subhra20/TetraGate/Gateway/LoRa_Gateway_TFT_EEPROM.pdf

05/09/2026

LoRa_Gateway_TFT_EEPROM Project Configuration Report

## 1. Description

### 1.1. Project

Project Name | LoRa_Gateway_TFT_EEPROM
Board Name | NUCLEO-F429ZI
Generated with: | STM32CubeMX 6.15.0
Date | 09/05/2026

### 1.2. MCU

MCU Series | STM32F4
MCU Line | STM32F429/439
MCU name | STM32F429ZITx
MCU Package | LQFP144
MCU Pin number | 144

### 1.3. Core(s) information

Core(s) | Arm Cortex-M4

## 2. Pinout Configuration

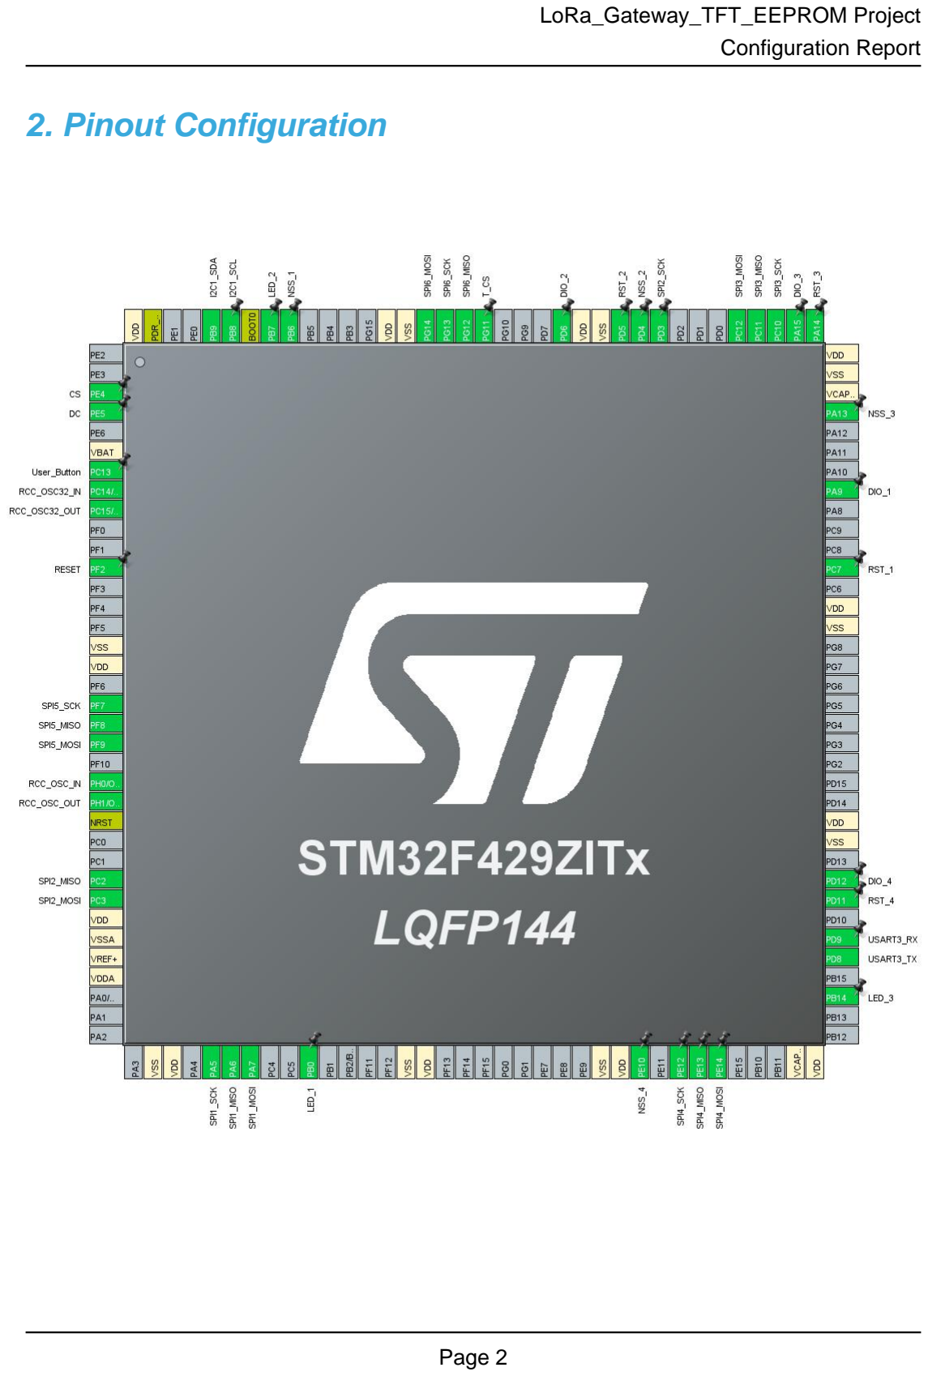
[picture p8: page 3]

## 3. Pins Configuration

Pin Number LQFP144 | Pin Name (function after reset) | Pin Type | Alternate Function(s) | Label
3 | PE4 * | I/O | GPIO_Output | CS
4 | PE5 * | I/O | GPIO_Output | DC
6 | VBAT | Power
7 | PC13 | I/O | GPIO_EXTI13 | User_Button
8 | PC14/OSC32_IN | I/O | RCC_OSC32_IN
9 | PC15/OSC32_OUT | I/O | RCC_OSC32_OUT
12 | PF2 * | I/O | GPIO_Output | RESET
16 | VSS | Power
17 | VDD | Power
19 | PF7 | I/O | SPI5_SCK
20 | PF8 | I/O | SPI5_MISO
21 | PF9 | I/O | SPI5_MOSI
23 | PH0/OSC_IN | I/O | RCC_OSC_IN
24 | PH1/OSC_OUT | I/O | RCC_OSC_OUT
25 | NRST | Reset
28 | PC2 | I/O | SPI2_MISO
29 | PC3 | I/O | SPI2_MOSI
30 | VDD | Power
31 | VSSA | Power
32 | VREF+ | Power
33 | VDDA | Power
38 | VSS | Power
39 | VDD | Power
41 | PA5 | I/O | SPI1_SCK
42 | PA6 | I/O | SPI1_MISO
43 | PA7 | I/O | SPI1_MOSI
46 | PB0 * | I/O | GPIO_Output | LED_1
51 | VSS | Power
52 | VDD | Power
61 | VSS | Power
62 | VDD | Power
63 | PE10 * | I/O | GPIO_Output | NSS_4
65 | PE12 | I/O | SPI4_SCK
66 | PE13 | I/O | SPI4_MISO
67 | PE14 | I/O | SPI4_MOSI
71 | VCAP_1 | Power

Pin Number LQFP144 | Pin Name (function after reset) | Pin Type | Alternate Function(s) | Label
72 | VDD | Power
75 | PB14 * | I/O | GPIO_Output | LED_3
77 | PD8 | I/O | USART3_TX
78 | PD9 | I/O | USART3_RX
80 | PD11 * | I/O | GPIO_Output | RST_4
81 | PD12 | I/O | GPIO_EXTI12 | DIO_4
83 | VSS | Power
84 | VDD | Power
94 | VSS | Power
95 | VDD | Power
97 | PC7 * | I/O | GPIO_Output | RST_1
101 | PA9 | I/O | GPIO_EXTI9 | DIO_1
105 | PA13 * | I/O | GPIO_Output | NSS_3
106 | VCAP_2 | Power
107 | VSS | Power
108 | VDD | Power
109 | PA14 * | I/O | GPIO_Output | RST_3
110 | PA15 | I/O | GPIO_EXTI15 | DIO_3
111 | PC10 | I/O | SPI3_SCK
112 | PC11 | I/O | SPI3_MISO
113 | PC12 | I/O | SPI3_MOSI
117 | PD3 | I/O | SPI2_SCK
118 | PD4 * | I/O | GPIO_Output | NSS_2
119 | PD5 * | I/O | GPIO_Output | RST_2
120 | VSS | Power
121 | VDD | Power
122 | PD6 | I/O | GPIO_EXTI6 | DIO_2
126 | PG11 * | I/O | GPIO_Output | T_CS
127 | PG12 | I/O | SPI6_MISO
128 | PG13 | I/O | SPI6_SCK
129 | PG14 | I/O | SPI6_MOSI
130 | VSS | Power
131 | VDD | Power
136 | PB6 * | I/O | GPIO_Output | NSS_1
137 | PB7 * | I/O | GPIO_Output | LED_2
138 | BOOT0 | Boot
139 | PB8 | I/O | I2C1_SCL
140 | PB9 | I/O | I2C1_SDA
143 | PDR_ON | Reset

Pin Number LQFP144 | Pin Name (function after reset) | Pin Type | Alternate Function(s) | Label
144 | VDD | Power

* The pin is affected with an I/O function

## 4. Clock Tree Configuration

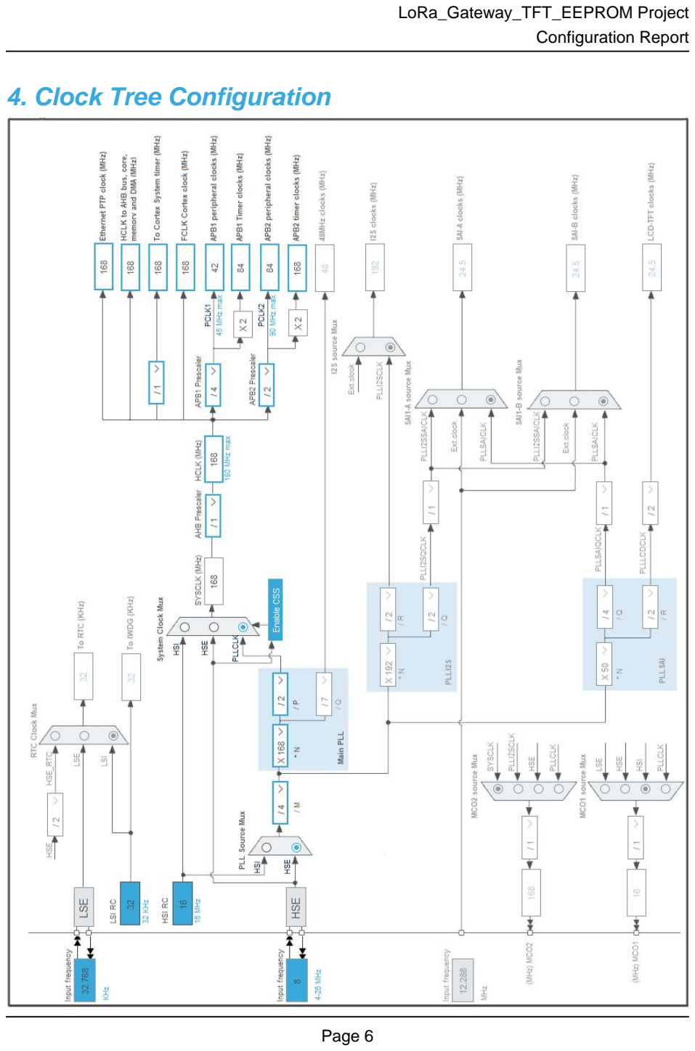
[picture p9: page 7]

## 1. Power Consumption Calculator report

### 1.1. Microcontroller Selection

Series | STM32F4
Line | STM32F429/439
MCU | STM32F429ZITx
Datasheet | DS9405_Rev9

### 1.2. Parameter Selection

Temperature | 25
Vdd | 3.3

### 1.3. Battery Selection

Battery | Li-SOCL2(A3400)
Capacity | 3400.0 mAh
Self Discharge | 0.08 %/month
Nominal Voltage | 3.6 V
Max Cont Current | 100.0 mA
Max Pulse Current | 200.0 mA
Cells in series | 1
Cells in parallel | 1

### 1.4. Sequence

Step | Step1 | Step2
Mode | RUN | STOP_UDM (Under Drive)
Vdd | 3.3 | 3.3
Voltage Source | Battery | Battery
Range | Scale1-High | No Scale
Fetch Type | FLASH | n/a
CPU Frequency | 180 MHz | 0 Hz
Clock Configuration | HSE PLL | Regulator_LP Flash-PwrDwn
Clock Source Frequency | 4 MHz | 0 Hz
Peripherals
Additional Cons. | 0 mA | 0 mA
Average Current | 57 mA | 100 µA
Duration | 0.1 ms | 0.9 ms
DMIPS | 225.0 | 0.0
Ta Max | 97.48 | 104.99
Category | In DS Table | In DS Table

### 1.5. Results

Sequence Time | 1 ms | Average Current | 5.79 mA
Battery Life | 24 days, 10 hours Average DMIPS | | 225.0 DMIPS

### 1.6. Chart

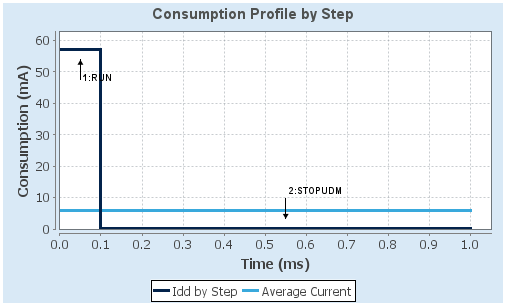
[picture p10: figure]

## 2. Software Project

### 2.1. Project Settings

Name | Value
Project Name | LoRa_Gateway_TFT_EEPROM
Project Folder | D:\STM32 CubeIDE
Toolchain / IDE | STM32CubeIDE
Firmware Package Name and Version | STM32Cube FW_F4 V1.28.3
Application Structure | Advanced
Generate Under Root | Yes
Do not generate the main() | No
Minimum Heap Size | 0x200
Minimum Stack Size | 0x400

### 2.2. Code Generation Settings

Name | Value
STM32Cube MCU packages and embedded software | Copy only the necessary library files
Generate peripheral initialization as a pair of '.c/.h' files | No
Backup previously generated files when re-generating | No
Keep User Code when re-generating | Yes
Delete previously generated files when not re-generated | Yes
Set all free pins as analog (to optimize the power consumption) | No
Enable Full Assert | No

### 2.3. Advanced Settings - Generated Function Calls

Rank | Function Name | Peripheral Instance Name
1 | SystemClock_Config | RCC
2 | MX_GPIO_Init | GPIO
3 | MX_I2C1_Init | I2C1
4 | MX_SPI1_Init | SPI1
5 | MX_SPI2_Init | SPI2
6 | MX_SPI3_Init | SPI3
7 | MX_SPI4_Init | SPI4
8 | MX_SPI5_Init | SPI5
9 | MX_SPI6_Init | SPI6
10 | MX_USART3_UART_Init | USART3

## 3. Peripherals and Middlewares Configuration

### 3.1. I2C1

I2C: I2C
3.1.1. Parameter Settings:

Master Features:

I2C Speed Mode | Fast Mode *
I2C Clock Speed (Hz) | 400000
Fast Mode Duty Cycle | Duty cycle Tlow/Thigh = 2
Timing configuration:
Coefficient of Digital Filter | 0
Analog Filter | Enabled
Slave Features:
Clock No Stretch Mode | Disabled
Primary Address Length selection | 7-bit
Dual Address Acknowledged | Disabled
Primary slave address | 0
General Call address detection | Disabled

### 3.2. RCC

High Speed Clock (HSE): Crystal/Ceramic Resonator Low Speed Clock (LSE) : Crystal/Ceramic Resonator
3.2.1. Parameter Settings:

System Parameters:

VDD voltage (V) | 3.3
Instruction Cache | Enabled
Prefetch Buffer | Enabled
Data Cache | Enabled
Flash Latency(WS) | 5 WS (6 CPU cycle)
RCC Parameters:
HSI Calibration Value | 16
TIM Prescaler Selection | Disabled
HSE Startup Timout Value (ms) | 100
LSE Startup Timout Value (ms) | 5000
Power Parameters:
Power Regulator Voltage Scale | Power Regulator Voltage Scale 1
Power Over Drive | Disabled

### 3.3. SPI1

Mode: Full-Duplex Master
3.3.1. Parameter Settings:

Basic Parameters:

Frame Format | Motorola
Data Size | 8 Bits
First Bit | MSB First
Clock Parameters:
Prescaler (for Baud Rate) | 8 *
Baud Rate | 10.5 MBits/s *
Clock Polarity (CPOL) | Low
Clock Phase (CPHA) | 1 Edge
Advanced Parameters:
CRC Calculation | Disabled
NSS Signal Type | Software

### 3.4. SPI2

Mode: Full-Duplex Master
3.4.1. Parameter Settings:

Basic Parameters:

Frame Format | Motorola
Data Size | 8 Bits
First Bit | MSB First
Clock Parameters:
Prescaler (for Baud Rate) | 2
Baud Rate | 21.0 MBits/s *
Clock Polarity (CPOL) | Low
Clock Phase (CPHA) | 1 Edge
Advanced Parameters:
CRC Calculation | Disabled
NSS Signal Type | Software

### 3.5. SPI3

Mode: Full-Duplex Master
3.5.1. Parameter Settings:

Basic Parameters:

Frame Format | Motorola
Data Size | 8 Bits
First Bit | MSB First
Clock Parameters:
Prescaler (for Baud Rate) | 2
Baud Rate | 21.0 MBits/s *
Clock Polarity (CPOL) | Low
Clock Phase (CPHA) | 1 Edge
Advanced Parameters:
CRC Calculation | Disabled
NSS Signal Type | Software

### 3.6. SPI4

Mode: Full-Duplex Master
3.6.1. Parameter Settings:

Basic Parameters:

Frame Format | Motorola
Data Size | 8 Bits
First Bit | MSB First
Clock Parameters:
Prescaler (for Baud Rate) | 2
Baud Rate | 42.0 MBits/s *
Clock Polarity (CPOL) | Low
Clock Phase (CPHA) | 1 Edge
Advanced Parameters:
CRC Calculation | Disabled
NSS Signal Type | Software

### 3.7. SPI5

Mode: Full-Duplex Master
3.7.1. Parameter Settings:

Basic Parameters:

Frame Format | Motorola
Data Size | 8 Bits
First Bit | MSB First
Clock Parameters:
Prescaler (for Baud Rate) | 2
Baud Rate | 42.0 MBits/s *
Clock Polarity (CPOL) | Low
Clock Phase (CPHA) | 1 Edge
Advanced Parameters:
CRC Calculation | Disabled
NSS Signal Type | Software

### 3.8. SPI6

Mode: Full-Duplex Master
3.8.1. Parameter Settings:

Basic Parameters:

Frame Format | Motorola
Data Size | 8 Bits
First Bit | MSB First
Clock Parameters:
Prescaler (for Baud Rate) | 2
Baud Rate | 42.0 MBits/s *
Clock Polarity (CPOL) | Low
Clock Phase (CPHA) | 1 Edge
Advanced Parameters:
CRC Calculation | Disabled
NSS Signal Type | Software

### 3.9. SYS

Timebase Source: SysTick

### 3.10. USART3

Mode: Asynchronous
3.10.1. Parameter Settings:

Basic Parameters:

Baud Rate | 115200
Word Length | 8 Bits (including Parity)
Parity | None
Stop Bits | 1
Advanced Parameters:
Data Direction | Receive and Transmit
Over Sampling | 16 Samples

* User modified value

## 4. System Configuration

### 4.1. GPIO configuration

IP | Pin | Signal | GPIO mode | GPIO pull/up pull down

Max
Speed

User Label

I2C1 | PB8 | I2C1_SCL | Alternate Function Open Drain | No pull-up and no pull-down | Very High
*
| PB9 | I2C1_SDA | Alternate Function Open Drain | No pull-up and no pull-down | Very High
*
RCC | PC14/OSC3 2_IN | RCC_OSC32_IN | n/a | n/a | n/a
| PC15/OSC3 2_OUT | RCC_OSC32_O UT | n/a | n/a | n/a
| PH0/OSC_I N | RCC_OSC_IN | n/a | n/a | n/a
| PH1/OSC_O UT | RCC_OSC_OUT | n/a | n/a | n/a
SPI1 | PA5 | SPI1_SCK | Alternate Function Push Pull | No pull-up and no pull-down | Very High
*
| PA6 | SPI1_MISO | Alternate Function Push Pull | No pull-up and no pull-down | Very High
*
| PA7 | SPI1_MOSI | Alternate Function Push Pull | No pull-up and no pull-down | Very High
*
SPI2 | PC2 | SPI2_MISO | Alternate Function Push Pull | No pull-up and no pull-down | Very High
*
| PC3 | SPI2_MOSI | Alternate Function Push Pull | No pull-up and no pull-down | Very High
*
| PD3 | SPI2_SCK | Alternate Function Push Pull | No pull-up and no pull-down | Very High
*
SPI3 | PC10 | SPI3_SCK | Alternate Function Push Pull | No pull-up and no pull-down | Very High
*
| PC11 | SPI3_MISO | Alternate Function Push Pull | No pull-up and no pull-down | Very High
*
| PC12 | SPI3_MOSI | Alternate Function Push Pull | No pull-up and no pull-down | Very High
*
SPI4 | PE12 | SPI4_SCK | Alternate Function Push Pull | No pull-up and no pull-down | Very High
*
| PE13 | SPI4_MISO | Alternate Function Push Pull | No pull-up and no pull-down | Very High
*

IP | Pin | Signal | GPIO mode | GPIO pull/up pull down | Max Speed | User Label
| PE14 | SPI4_MOSI | Alternate Function Push Pull | No pull-up and no pull-down | Very High *
SPI5 | PF7 | SPI5_SCK | Alternate Function Push Pull | No pull-up and no pull-down | Very High *
| PF8 | SPI5_MISO | Alternate Function Push Pull | No pull-up and no pull-down | Very High *
| PF9 | SPI5_MOSI | Alternate Function Push Pull | No pull-up and no pull-down | Very High *
SPI6 | PG12 | SPI6_MISO | Alternate Function Push Pull | No pull-up and no pull-down | Very High *
| PG13 | SPI6_SCK | Alternate Function Push Pull | No pull-up and no pull-down | Very High *
| PG14 | SPI6_MOSI | Alternate Function Push Pull | No pull-up and no pull-down | Very High *
USART3 | PD8 | USART3_TX | Alternate Function Push Pull | No pull-up and no pull-down | Very High *
| PD9 | USART3_RX | Alternate Function Push Pull | No pull-up and no pull-down | Very High *
GPIO | PE4 | GPIO_Output | Output Push Pull | No pull-up and no pull-down | Low | CS
PE5 | GPIO_Output | Output Push Pull | No pull-up and no pull-down | Low | DC
PC13 | GPIO_EXTI13 | External Interrupt Mode with Rising edge trigger detection | No pull-up and no pull-down | n/a | User_Button
PF2 | GPIO_Output | Output Push Pull | No pull-up and no pull-down | Low | RESET
PB0 | GPIO_Output | Output Push Pull | No pull-up and no pull-down | Low | LED_1
PE10 | GPIO_Output | Output Push Pull | No pull-up and no pull-down | Low | NSS_4
PB14 | GPIO_Output | Output Push Pull | No pull-up and no pull-down | Low | LED_3
PD11 | GPIO_Output | Output Push Pull | No pull-up and no pull-down | Low | RST_4
PD12 | GPIO_EXTI12 | External Interrupt Mode with Rising edge trigger detection | No pull-up and no pull-down | n/a | DIO_4
PC7 | GPIO_Output | Output Push Pull | No pull-up and no pull-down | Low | RST_1
PA9 | GPIO_EXTI9 | External Interrupt Mode with Rising edge trigger detection | No pull-up and no pull-down | n/a | DIO_1
PA13 | GPIO_Output | Output Push Pull | No pull-up and no pull-down | Low | NSS_3
PA14 | GPIO_Output | Output Push Pull | No pull-up and no pull-down | Low | RST_3
PA15 | GPIO_EXTI15 | External Interrupt Mode with Rising edge trigger detection | No pull-up and no pull-down | n/a | DIO_3
PD4 | GPIO_Output | Output Push Pull | No pull-up and no pull-down | Low | NSS_2
PD5 | GPIO_Output | Output Push Pull | No pull-up and no pull-down | Low | RST_2
PD6 | GPIO_EXTI6 | External Interrupt Mode with Rising edge trigger detection | No pull-up and no pull-down | n/a | DIO_2

IP | Pin | Signal | GPIO mode | GPIO pull/up pull down | Max Speed | User Label
| PG11 | GPIO_Output | Output Push Pull | No pull-up and no pull-down | Low | T_CS
| PB6 | GPIO_Output | Output Push Pull | No pull-up and no pull-down | Low | NSS_1
| PB7 | GPIO_Output | Output Push Pull | No pull-up and no pull-down | Low | LED_2

### 4.2. DMA configuration

nothing configured in DMA service

### 4.3. NVIC configuration

4.3.1. NVIC
Interrupt Table | Enable | Preenmption Priority | SubPriority
Non maskable interrupt | true | 0 | 0
Hard fault interrupt | true | 0 | 0
Memory management fault | true | 0 | 0
Pre-fetch fault, memory access fault | true | 0 | 0
Undefined instruction or illegal state | true | 0 | 0
System service call via SWI instruction | true | 0 | 0
Debug monitor | true | 0 | 0
Pendable request for system service | true | 0 | 0
System tick timer | true | 0 | 0
USART3 global interrupt | true | 0 | 0
PVD interrupt through EXTI line 16 | | unused
Flash global interrupt | | unused
RCC global interrupt | | unused
EXTI line[9:5] interrupts | | unused
I2C1 event interrupt | | unused
I2C1 error interrupt | | unused
SPI1 global interrupt | | unused
SPI2 global interrupt | | unused
EXTI line[15:10] interrupts | | unused
SPI3 global interrupt | | unused
FPU global interrupt | | unused
SPI4 global interrupt | | unused
SPI5 global interrupt | | unused
SPI6 global interrupt | | unused
4.3.2. NVIC Code generation

Enabled interrupt Table Select for init
sequence ordering
| | Generate IRQ
| | handler | Call HAL handler
Non maskable interrupt | false | true | false
Hard fault interrupt | false | true | false
Memory management fault | false | true | false
Pre-fetch fault, memory access fault | false | true | false
Undefined instruction or illegal state | false | true | false
System service call via SWI instruction | false | true | false
Debug monitor | false | true | false
Pendable request for system service | false | true | false
System tick timer | false | true | true

Enabled interrupt Table | Select for init sequence ordering | Generate IRQ handler | Call HAL handler
USART3 global interrupt | false | true | true

* User modified value

## 5. System Views

5.1. Category view
5.1.1. Current

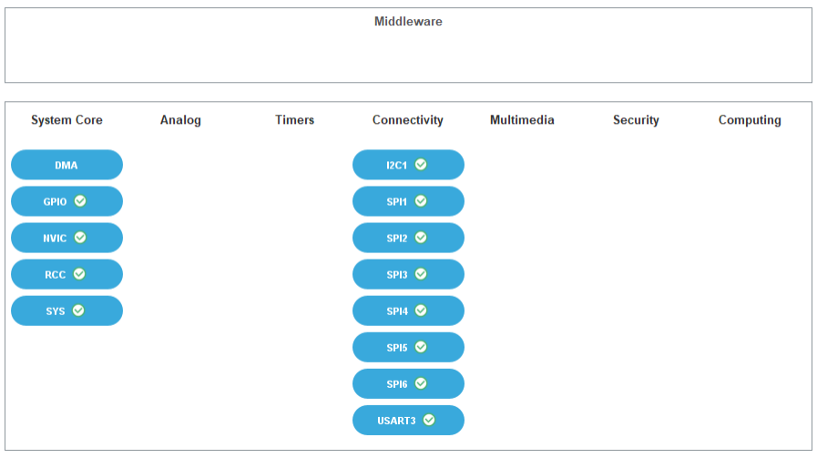
[picture p11: figure]

## 6. Docs & Resources

Type | Link
BSDL files | https://www.st.com/resource/en/bsdl_model/stm32f427-437_429-439_bsdl.zip
IBIS models | https://www.st.com/resource/en/ibis_model/stm32f427-437_429-439_ibis.zip
System View Description | https://www.st.com/resource/en/svd/stm32f4-svd.zip
Presentations | https://www.st.com/resource/en/product_presentation/stm32-stm8_embedded_software_solutions.pdf
Presentations | https://www.st.com/resource/en/product_presentation/stm32_eval-tools_portfolio.pdf
Presentations | https://www.st.com/resource/en/product_presentation/stm32_stm8_functi onal-safety-packages.pdf
Presentations | https://www.st.com/resource/en/product_presentation/stm32-stm8_software_development_tools.pdf
Presentations | https://www.st.com/resource/en/product_presentation/microcontrollers-stm32-family-overview.pdf
Flyers | https://www.st.com/resource/en/flyer/flstm32nucleo.pdf
Flyers | https://www.st.com/resource/en/flyer/flstm32trust.pdf
Flyers | https://www.st.com/resource/en/flyer/flstm32gui.pdf
Product Certifications | https://www.st.com/resource/en/certification_document/stm32_authentication_can.pdf
Security Bulletin | https://www.st.com/resource/en/technical_note/tn1489-security-bulletin-tn1489stpsirt-physical-attacks-on-stm32-and-stm32cube-firmware-stmicroelectronics.pdf
Application Notes | https://www.st.com/resource/en/application_note/an1709-emc-design-guide-for-stm8-stm32-and-legacy-mcus-stmicroelectronics.pdf
Application Notes | https://www.st.com/resource/en/application_note/an2945-stm8s-and-stm32-mcus-a-consistent-832bit-product-line-for-painless-migration-stmicroelectronics.pdf

Application Notes | https://www.st.com/resource/en/application_note/an3070-managing-the-driver-enable-signal-for-rs485-and-iolink-communications-with-the-stm32s-usart-stmicroelectronics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
Application Notes | https://www.st.com/resource/en/application_note/an3364-migration-and-compatibility-guidelines-for-stm32-microcontroller-applications-stmicroelectronics.pdf
Application Notes | https://www.st.com/resource/en/application_note/an3997-audio-playback-and-recording-using-the-stm32f4discovery-stmicroelectronics.pdf
Application Notes | https://www.st.com/resource/en/application_note/an3998-pdm-audio-software-decoding-on-stm32-microcontrollers-stmicroelectronics.pdf
Application Notes | https://www.st.com/resource/en/application_note/an4031-using-the-stm32f2-stm32f4-and-stm32f7-series-dma-controller-stmicroelectronics.pdf
Application Notes | https://www.st.com/resource/en/application_note/an4073-how-to-improve-adc-accuracy-when-using-stm32f2xx-and-stm32f4xx-microcontrollers-stmicroelectronics.pdf
Application Notes | https://www.st.com/resource/en/application_note/an4221-i2c-protocol-used-in-the-stm32-bootloader-stmicroelectronics.pdf
Application Notes | https://www.st.com/resource/en/application_note/an4488-getting-started-with-stm32f4xxxx-mcu-hardware-development-stmicroelectronics.pdf
Application Notes | https://www.st.com/resource/en/application_note/an4547-migrating-from-stm32f407xx417xx-to-stm32f427xx429xx437xx439xx-stmicroelectronics.pdf
Application Notes | https://www.st.com/resource/en/application_note/an4640-peripherals-interconnections-on-stm32f4057xx-stm32f4157xx-stm32f42xxx-stm32f43xxx-stm32f446xx-and-stm32f469479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
Application Notes | https://www.st.com/resource/en/application_note/an4655-virtually-increasing-the-number-of-serial-communication-peripherals-in-stm32-applications-stmicroelectronics.p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
Application Notes | https://www.st.com/resource/en/application_note/an4658-migration-of-applications-from-stm32f429439-lines-to-stm32f446-line-stmicroelectronics.pdf
Application Notes | https://www.st.com/resource/en/application_note/an4675-migration-of- microcontroller-applications-from-stm32f42xxxstm32f43xxx-to-

| stm32f469xxstm32f479xx-stmicroelectronics.pdf
Application Notes | https://www.st.com/resource/en/application_note/an4739-stm32cube-firmware-examples-for-stm32f4-series-stmicroelectronics.pdf
Application Notes | https://www.st.com/resource/en/application_note/an4750-handling-of-soft-errors-in-stm32-applications-stmicroelectronics.pdf
Application Notes | https://www.st.com/resource/en/application_note/an4803-highspeed-si-simulations-using-ibis-and-boardlevel-simulations-using-hyperlynx-si-on-stm32-mcus-and-mpus-stmic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
Application Notes | https://www.st.com/resource/en/application_note/an4850-stm32-mcus-spreadspectrum-clock-generation-principles-properties-and-implementation-stmicroelectronics.pdf
Application Notes | https://www.st.com/resource/en/application_note/an4995-using-an-electromyogram-technique-to-detect-muscle-activity-stmicroelectronics.pdf
Application Notes | https://www.st.com/resource/en/application_note/an5027-interfacing-pdm-digital-microphones-using-stm32-mcus-and-mpus-stmicroelectronics.pdf
Application Notes | https://www.st.com/resource/en/application_note/an5073-receiving-spdif-audio-stream-with-the-stm32f4f7h7-series-stmicroelectronics.pdf
Application Notes | https://www.st.com/resource/en/application_note/an4899-stm32-microcontroller-gpio-hardware-settings-and-lowpower-consumption-stmicroelectronics.pdf
Application Notes | https://www.st.com/resource/en/application_note/an5612-esd-protection-of-stm32-mcus-and-mpus-stmicroelectronics.pdf
Application Notes | https://www.st.com/resource/en/application_note/an4838-introduction-to-memory-protection-unit-management-on-stm32-mcus-stmicroelectronics.pdf
Application Notes | https://www.st.com/resource/en/application_note/an5688-migrating-microcontroller-applications-from-stm32f427437-and-stm32f429439-to-stm32h573563-and-stm32h562-mcus-s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
Application Notes | https://www.st.com/resource/en/application_note/an4879-introduction-to-usb-hardware-and-pcb-guidelines-using-stm32-mcus-stmicroelectronics.pdf
Application Notes | https://www.st.com/resource/en/application_note/an5225-introduction-to-

| usb-typec-power-delivery-for-stm32-mcus-and-mpus-stmicroelectronics.pdf
Application Notes | https://www.st.com/resource/en/application_note/an5537-how-to-use-adc-oversampling-techniques-to-improve-signaltonoise-ratio-on-stm32-mcus-stmicroelectronics.pdf
Application Notes | https://www.st.com/resource/en/application_note/an4230-introduction-to-random-number-generation-validation-using-the-nist-statistical-test-suite-for-stm32-mcus-and-m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
Application Notes | https://www.st.com/resource/en/application_note/an2867-guidelines-for-oscillator-design-on-stm8afals-and-stm32-mcusmpus-stmicroelectronics.pdf
Application Notes | https://www.st.com/resource/en/application_note/an4013-introduction-to-timers-for-stm32-mcus-stmicroelectronics.pdf
Application Notes | https://www.st.com/resource/en/application_note/an4277-how-to-use-pwm-shutdown-for-motor-control-and-digital-power-conversion-on-stm32-mcus-stmicroelectronics.pdf
Application Notes | https://www.st.com/resource/en/application_note/an4861-introduction-to-lcdtft-display-controller-ltdc-on-stm32-mcus-stmicroelectronics.pdf
Application Notes | https://www.st.com/resource/en/application_note/an4908-getting-started-with-usart-automatic-baud-rater-detection-for-stm32-mcus-stmicroelectronics.pdf
Application Notes | https://www.st.com/resource/en/application_note/an5156-introduction-to-security-for-stm32-mcus-stmicroelectronics.pdf
Application Notes | https://www.st.com/resource/en/application_note/an5543-guidelines-for-enhanced-spi-communication-on-stm32-mcus-and-mpus-stmicroelectronics.pdf
Application Notes | https://www.st.com/resource/en/application_note/cd00211314-how-to-optimize-the-adc-accuracy-in-the-stm32-mcus-stmicroelectronics.pdf
Application Notes | https://www.st.com/resource/en/application_note/an2639-soldering-recommendations-and-package-information-for-leadfree-ecopack2-mcus-and-mpus-stmicroelectronics.pdf
Application Notes | https://www.st.com/resource/en/application_note/an5020-introduction-to-digital-camera-interface-dcmi-for-stm32-mcus-stmicroelectronics.pdf

Application Notes | https://www.st.com/resource/en/application_note/an3154-how-to-use-can-protocol-in-bootloader-on-stm32-mcus-stmicroelectronics.pdf
Application Notes | https://www.st.com/resource/en/application_note/an4566-how-to-extend-the-dac-performance-on-stm32-mcus-stmicroelectronics.pdf
Application Notes | https://www.st.com/resource/en/application_note/an5647-the-goertzel-algorithm-to-compute-individual-terms-of-the-discrete-fourier-transform-dft-in-stm32-products-stm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
Application Notes | https://www.st.com/resource/en/application_note/an2606-introduction-to-system-memory-boot-mode-on-stm32-mcus-stmicroelectronics.pdf
Application Notes | https://www.st.com/resource/en/application_note/an5036-guidelines-for-thermal-management-on-stm32-mcus-and-mpus-stmicroelectronics.pdf
Application Notes | https://www.st.com/resource/en/application_note/an3126-how-to-use-dac-for-audio-and-waveform-generation-on-stm32-mcus-and-mpus-stmicroelectronics.pdf
Application Notes | https://www.st.com/resource/en/application_note/an3155-how-to-use-usart-protocol-in-bootloader-on-stm32-mcus-stmicroelectronics.pdf
Application Notes | https://www.st.com/resource/en/application_note/an3156-how-to-use-usb-dfu-protocol-in-bootloader-on-stm32-mcus-stmicroelectronics.pdf
Application Notes | https://www.st.com/resource/en/application_note/an4286-how-to-use-spi-protocol-in-bootloader-on-stm32-mcus-stmicroelectronics.pdf
Application Notes | https://www.st.com/resource/en/application_note/an4759-introduction-to-using-the-hardware-realtime-clock-rtc-and-the-tamper-management-unit-tamp-for-stm32-mcus-stmic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
Application Notes | https://www.st.com/resource/en/application_note/an4776-how-to-use-generalpurpose-timer-peripheral-on-stm32-mcus-stmicroelectronics.pdf
Application Notes | https://www.st.com/resource/en/application_note/an4989-introduction-to-debug-toolbox-for-stm32-mcus-stmicroelectronics.pdf
Application Notes | https://www.st.com/resource/en/application_note/an6188-migrating-from-the-stm32f427437-or-stm32f429439-to-the-stm32h5ex5fx-mcus-stmicroelectronics.pdf
Application Notes | https://www.st.com/resource/en/application_note/an4660-migrating-from-stm32f42xxx43xxx-to-stm32f7-mcus-stmicroelectronics.pdf
Errata Sheets | https://www.st.com/resource/en/errata_sheet/es0206-stm32f427437-and-

| stm32f429439-device-errata-stmicroelectronics.pdf
Datasheet | https://www.st.com/resource/en/datasheet/dm00071990.pdf
Programming Manuals | https://www.st.com/resource/en/programming_manual/pm0214-stm32-cortexm4-mcus-and-mpus-programming-manual-stmicroelectronics.pdf
Reference Manuals | https://www.st.com/resource/en/reference_manual/rm0090-stm32f405415-stm32f407417-stm32f427437-and-stm32f429439-advanced-armbased-32bit-mcus-stmicroelectronics.pdf
Technical Notes & Articles | https://www.st.com/resource/en/technical_note/tn0516-overview-of-the-stm32f0xf100xxf103xx-and-stm32f2xxf30xf4xx-mcus-pmsm-singledual-foc-sdk-v40-stmicroelectronics.p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
Technical Notes & Articles | https://www.st.com/resource/en/technical_note/tn1163-description-of-wlcsp-for-microcontrollers-and-recommendations-for-its-use-stmicroelectronics.pdf
Technical Notes & Articles | https://www.st.com/resource/en/technical_note/tn1205-tape-and-reel-shipping-media-for-stm8-and-stm32-microcontrollers-in-fpn-packages-stmicroelectronics.pdf
Technical Notes & Articles | https://www.st.com/resource/en/technical_note/tn1206-tape-and-reel-shipping-media-for-stm8-and-stm32-microcontrollers-in-qfp-packages-stmicroelectronics.pdf
Technical Notes & Articles | https://www.st.com/resource/en/technical_note/tn1207-tape-and-reel-shipping-media-for-stm8-and-stm32-microcontrollers-in-so-packages-stmicroelectronics.pdf
Technical Notes & Articles | https://www.st.com/resource/en/technical_note/tn1208-tape-and-reel-shipping-media-for-stm8-and-stm32-microcontrollers-in-tssop-and-ssop-packages-stmicroelectronics.p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
Technical Notes & Articles | https://www.st.com/resource/en/technical_note/tn1433-reference-device-marking-schematics-for-stm32-microcontrollers-and-microprocessors-stmicroelectronics.pdf
Technical Notes & Articles | https://www.st.com/resource/en/technical_note/tn1204-tape-and-reel-shipping-media-for-stm32-devices-in-bga-packages-stmicroelectronics.pdf
User Manuals | https://www.st.com/resource/en/user_manual/um3461-stm32f4-series-ulcsaiec-607301603351-selftest-library-user-guide-stmicroelectronics.pdf
