subhra20/TetraGate/Gateway/Core/Inc/main.h

#define CS_Pin GPIO_PIN_4
#define CS_GPIO_Port GPIOE
#define DC_Pin GPIO_PIN_5
#define DC_GPIO_Port GPIOE
#define NSS_3_Pin GPIO_PIN_13
#define NSS_3_GPIO_Port GPIOC
#define RESET_Pin GPIO_PIN_2
#define RESET_GPIO_Port GPIOF
#define LED_1_Pin GPIO_PIN_0
#define LED_1_GPIO_Port GPIOB
#define NSS_4_Pin GPIO_PIN_10
#define NSS_4_GPIO_Port GPIOE
#define LED_3_Pin GPIO_PIN_14
#define LED_3_GPIO_Port GPIOB
#define RST_4_Pin GPIO_PIN_11
#define RST_4_GPIO_Port GPIOD
#define DIO_4_Pin GPIO_PIN_12
#define DIO_4_GPIO_Port GPIOD
#define RST_1_Pin GPIO_PIN_7
#define RST_1_GPIO_Port GPIOC
#define DIO_1_Pin GPIO_PIN_9
#define DIO_1_GPIO_Port GPIOA
#define DIO_3_Pin GPIO_PIN_15
#define DIO_3_GPIO_Port GPIOA
#define NSS_2_Pin GPIO_PIN_4
#define NSS_2_GPIO_Port GPIOD
#define RST_2_Pin GPIO_PIN_5
#define RST_2_GPIO_Port GPIOD
#define DIO_2_Pin GPIO_PIN_6
#define DIO_2_GPIO_Port GPIOD
#define T_CS_Pin GPIO_PIN_11
#define T_CS_GPIO_Port GPIOG
#define NSS_1_Pin GPIO_PIN_6
#define NSS_1_GPIO_Port GPIOB
#define RST_3_Pin GPIO_PIN_7
#define RST_3_GPIO_Port GPIOB
#define CCMRAM_ALIGN __attribute__((section(".ccmram")))
