subhra20/TetraGate/(commit log)

2026-11-11 TetraGate: four-channel LoRa gateway, nodes and PC console
    Brings three previously separate projects together as one documented
    device:
    Gateway/ STM32F429ZI, 4x RFM95W, LVGL touch UI, FreeRTOS
    Node/ STM32G030F6P6 + RFM95W transmitter
    PC_Console/ serial-to-HTTP bridge and browser console
    The air link carries a packed binary frame authenticated with a 4-byte
    AES-128-CMAC, with per-node keys derived from one master key. The MIC
    policy defaults to report-only so unsigned nodes keep working while they
    are reflashed one at a time.
    The master key shipped here is a PUBLISHED EXAMPLE and is not secret;
    lora_keys.h says so and the README explains how to generate a real one.
    Do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
2026-11-11 README: point at the v1.0.0 prebuilt firmware
    Adds a line under the hero image and a note in Build and flash, so a
    reader who only wants to run the device does not have to install a
    toolchain to find that out. Both say the release images carry the
    published example key and are for evaluation only.
2026-11-11 docs: add a recording of the live console to the README
    A 17-frame loop captured off the running gateway rather than staged, so
    the chart genuinely advances between frames. 1.9 MB at 900 px wide,
    which keeps it usable on a phone.
    Captured at 1480x960, the width the console's grid is designed for: a
    first attempt at 1320x860 wrapped the KPI row onto two lines and pushed
    the live chart below the fold.
2026-11-11 docs: resolve the two conflicting AES size figures
    02-Air-Protocol.md said "about 1.4 KB of code" while the README and the
    release notes said 3328 and 3064 bytes. Both were describing different
    things, but the page read as a contradiction.
    Replaces the estimate with a per-symbol table measured with
    arm-none-eabi-nm on the v1.0.0 node image (992 bytes of functions), and
    says explicitly that the 3064/3328 totals additionally cover the AES
    tables, the self-test vectors and the call sites.
    Found by asking a NotebookLM notebook built from these documents to
    cross-check every figure and name any source disagreements.
