subhra20/TetraGate/(notices)

Notices in the files:
Gateway/Core/Src/iwdg.c:
Copyright (c) 2026 STMicroelectronics.
All rights reserved.
This software is licensed under terms that can be found in the LICENSE file
